kamiyaowl-sandbox/esp_wifi_arduino/docs/表面実装タイプ・クリスタル（水晶発振子）　１６ＭＨｚ（５個入）_ パーツ一般 秋月電子通商 電子部品 ネット通販_files/P-01767.JPG

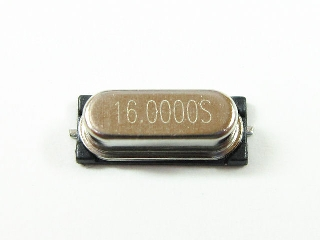
docs/表面実装タイプ・クリスタル（水晶発振子） １６ＭＨｚ（５個入）_ パーツ一般 秋月電子通商 電子部品 ネット通販_files/P-01767.JPG
