kamiyaowl-sandbox/esp_wifi_arduino/部品表.xlsx

Sheet: esp_wifi_arduino
部品名 | パッケージ | 回路リファレンス | 備考 | 実装数 | 10ボード作成で必要数 | 単価 | 販売単位 | 10ボード作成で購入数 | 価格 | 商社 | url
基板 |  |  |  | 1 | 10 | 1389 | 10 | 1 | 1389 | SwitchScience | https://www.switch-science.com/pcborder/
コンデンサ 22pF | SMD1608 | C4 C5 | 水晶接地用12pF~22pF | 2 | 20 | 200 | 100 | 1 | 200 | 秋月電子 | http://akizukidenshi.com/catalog/g/gP-05523/
コンデンサ 10uF | SMD1608 | C9 | レギュレータVout | 1 | 10 | 150 | 10 | 1 | 150 | 秋月電子 | http://akizukidenshi.com/catalog/g/gP-07768/
コンデンサ 0.1uF | SMD1608 | C1 C2 C3 C6 C7 C8 C10 | レギュレータVinも0.1uF | 7 | 70 | 100 | 200 | 1 | 100 | 秋月電子 | http://akizukidenshi.com/catalog/g/gP-04940/
赤色LED | SMD1608 | D1 | 電源LED | 1 | 10 | 200 | 20 | 1 | 200 | 秋月電子 | http://akizukidenshi.com/catalog/g/gI-03978/
青色LED | SMD1608 | D2 | D13 Lチカ用 | 1 | 10 | 200 | 20 | 1 | 200 | 秋月電子 | http://akizukidenshi.com/catalog/g/gI-03982/
抵抗 220Ω | SMD1608 | R1 R2 | LED電流制限用 | 2 | 20 | 500 | 2500 | 1 | 500 | 秋月電子 | http://akizukidenshi.com/catalog/g/gR-06221/
抵抗 10kΩ | SM1608 | R3 R4 R5 R6 R7 | プルアップ抵抗 | 5 | 50 | 500 | 2500 | 1 | 500 | 秋月電子 | http://akizukidenshi.com/catalog/g/gR-06103/
CONN_15 |  | P1 P2 | ピンヘッダ(2.54)×30 | 1 | 10 | 35 | 1 | 10 | 350 | 秋月電子 | http://akizukidenshi.com/catalog/g/gC-00167/
DIPSW4 | SMD4 | SW3 | ESPブートモード設定用 | 1 | 10 | 140 | 1 | 10 | 1400 | 秋月電子 | http://akizukidenshi.com/catalog/g/gP-08929/
SW_PUSH | SMD | SW1 SW2 | リセットスイッチ | 2 | 20 | 100 | 5 | 4 | 400 | 秋月電子 | http://akizukidenshi.com/catalog/g/gP-06185/
ATMEGA328P-A | TQFP32 | IC1 | ATMEGA88シリーズならピンコンパチ | 1 | 10 | 280 | 1 | 10 | 2800 | 秋月電子 | http://akizukidenshi.com/catalog/g/gI-04386/
ESP-WROOM-02 | SMD | U2 | 話題のWifiモジュール | 1 | 10 | 550 | 1 | 10 | 5500 | 秋月電子 | http://akizukidenshi.com/catalog/g/gM-09607/
NJM2391DL1-33 | TO-252-3 | U3 | 3.3V 1Aレギュレータ | 1 | 10 | 200 | 4 | 3 | 600 | 秋月電子 | http://akizukidenshi.com/catalog/g/gI-02252/
16MHz | HC-49 | X1 | 水晶 | 1 | 10 | 200 | 5 | 2 | 400 | 秋月電子 | http://akizukidenshi.com/catalog/g/gP-01767/
ADG3304 | TSSOP14 | U1 | 5V-3.3V双方向レベル変換 | 1 | 10 | 240 | 1 | 10 | 2400 | マルツ | http://www.marutsu.co.jp/pc/i/170346/
 |  |  |  |  |  |  |  | 小計 | 17089

Sheet: 注文履歴
 | 請求額
SwitchScience 基板 | 1713
SwitchScience 基板 | 1713
マルツ ADG3304 10個 | 3030
秋月小計 | 14300
秋月私物注文分 | -5800
 | 14956
