kamiyaowl-sandbox/esp_wifi_arduino/esp_wifi_sch.pdf

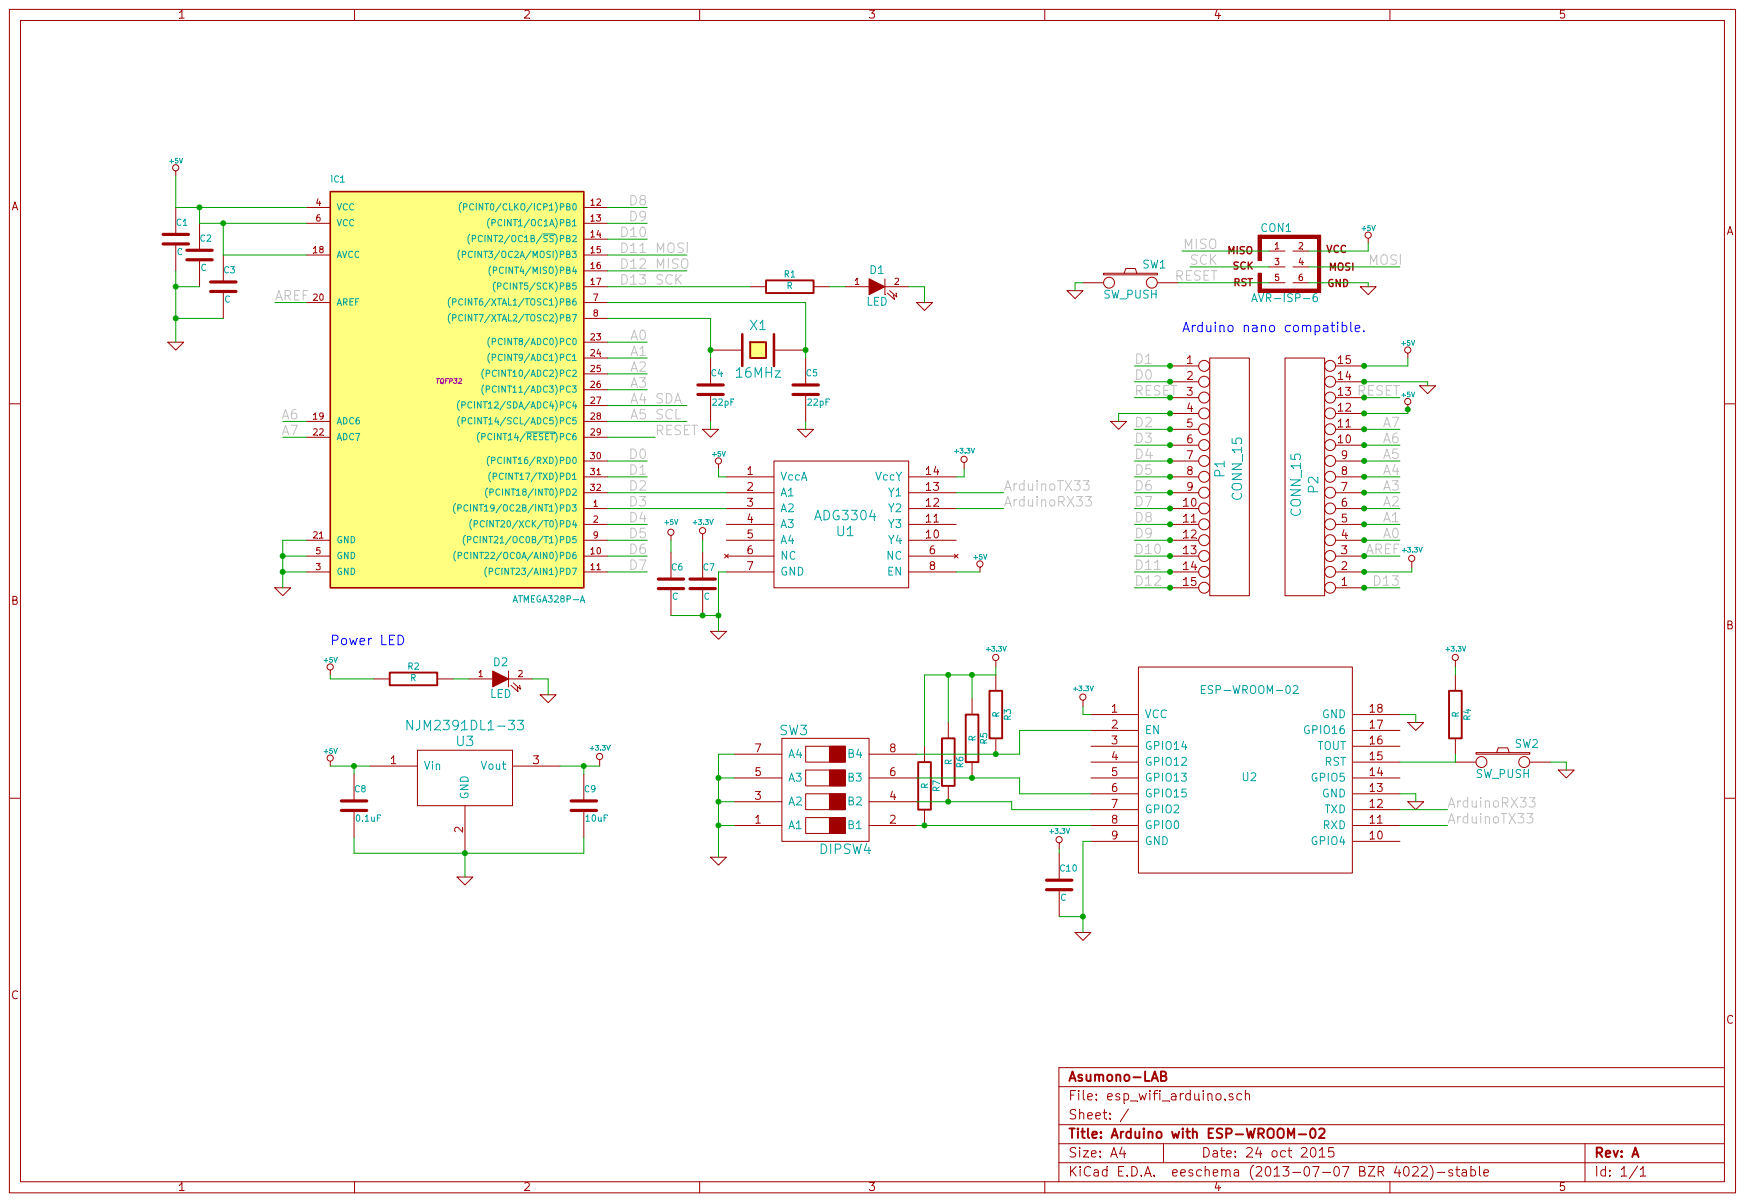
[picture p6: page 1]
