kamiyaowl-sandbox/esp_wifi_arduino/esp_wifi_arduino.kicad_pcb

## KiCad design esp_wifi_arduino.kicad_pcb (2015-12-02)

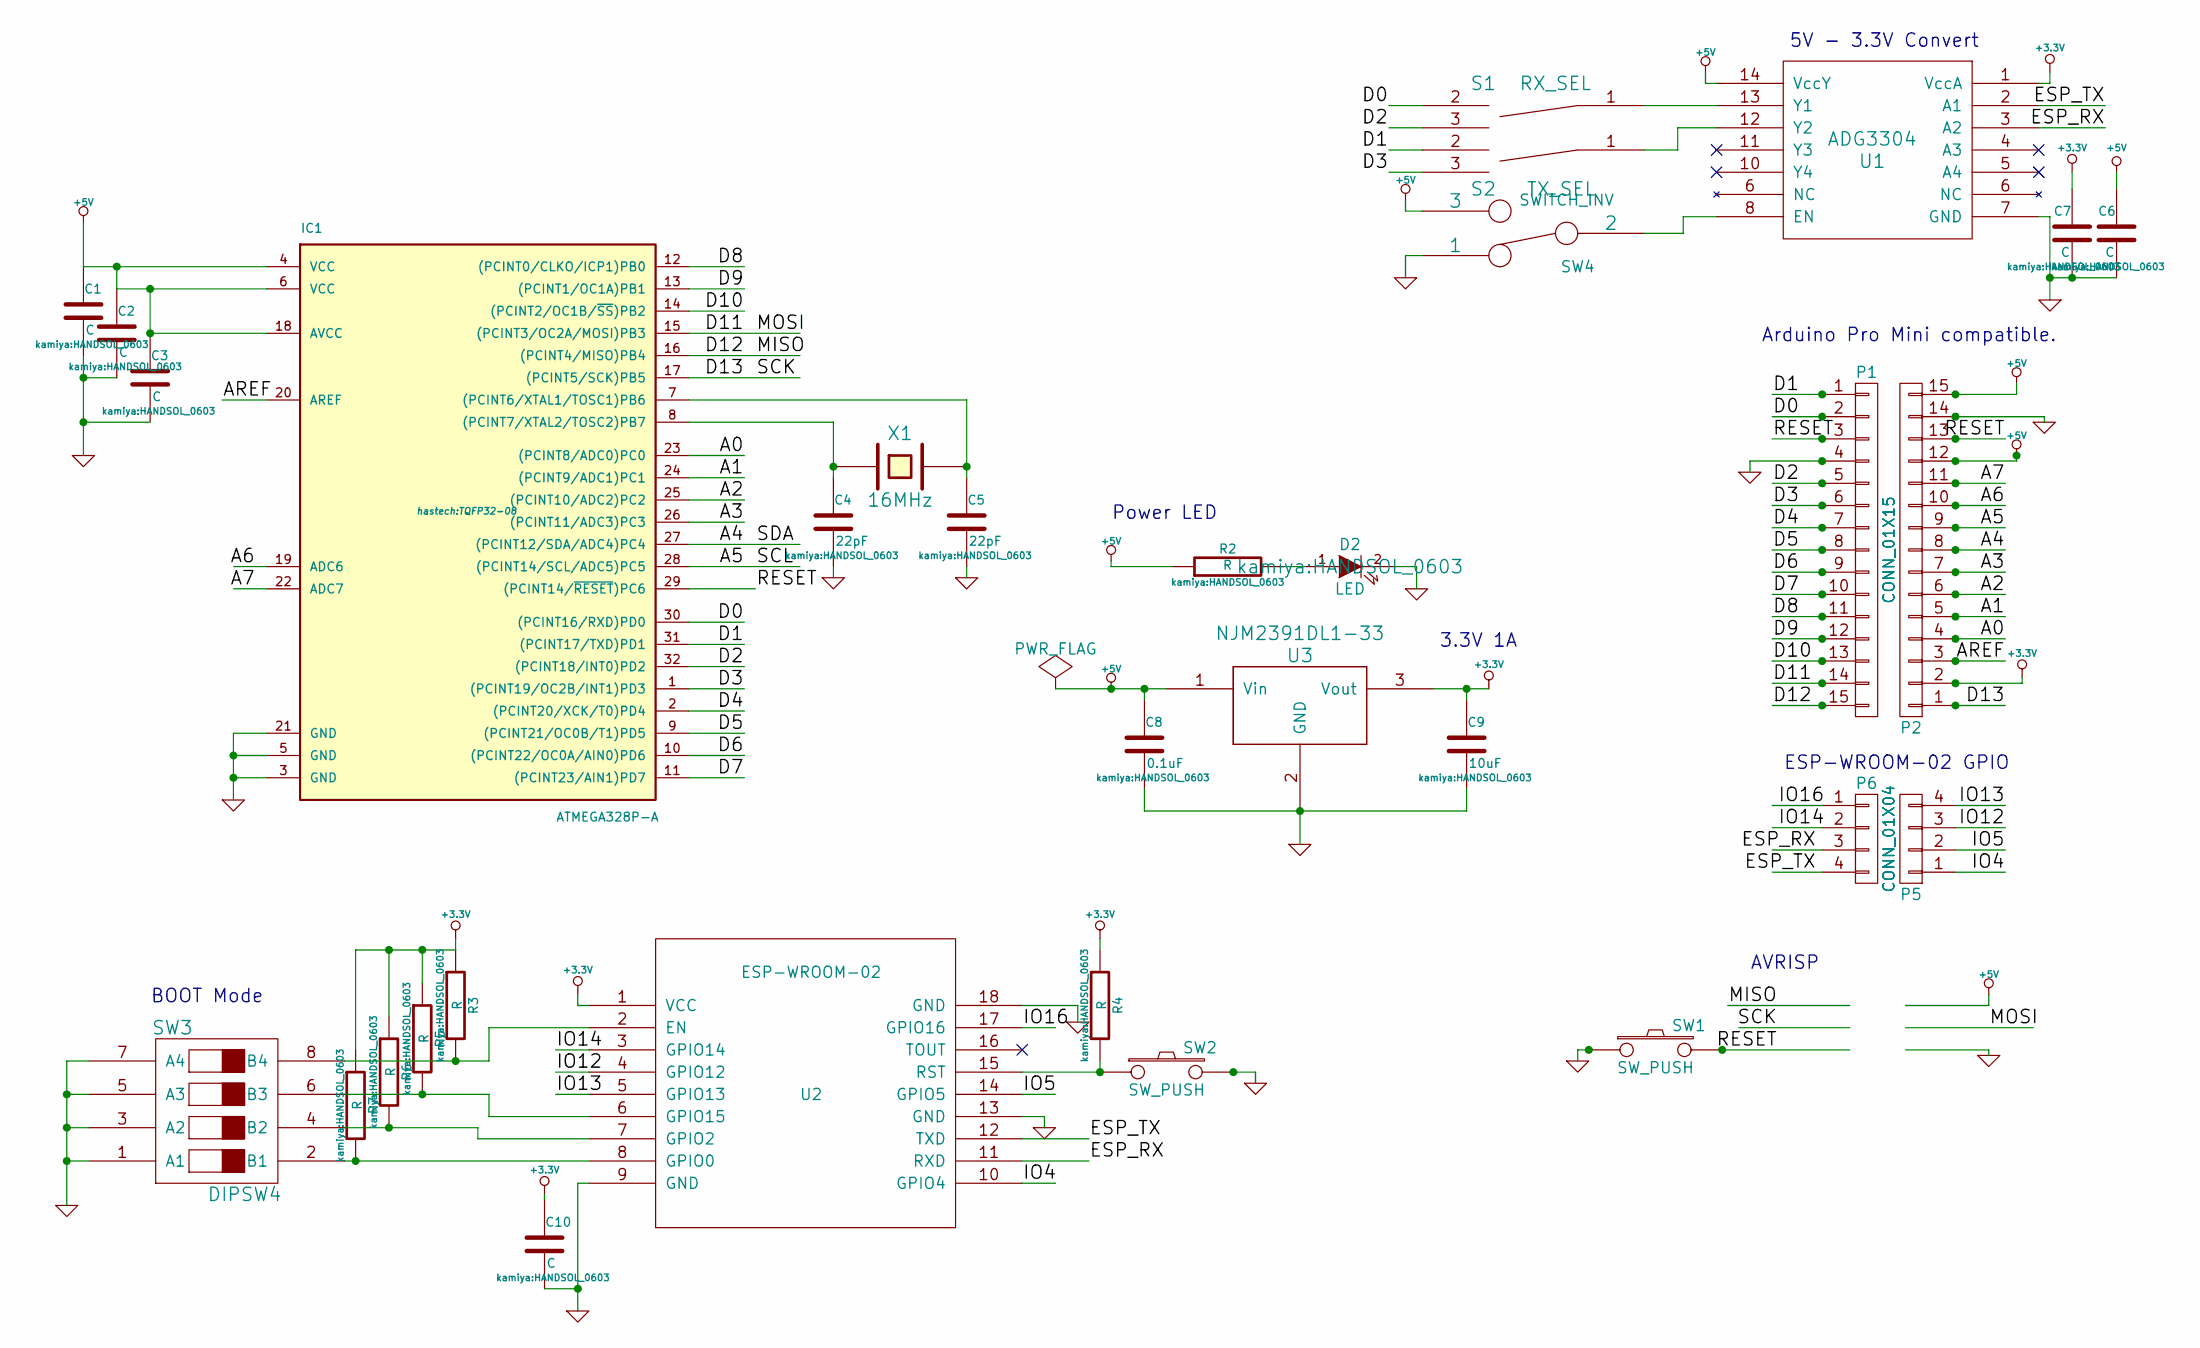
[picture p7: schematic esp_wifi_arduino.sch, Arduino with ESP-WROOM-02]

Parts:
C1, C2, C3, C6, C7, C10: C; HANDSOL_0603
C4, C5: 22pF; HANDSOL_0603
C8: 0.1uF; HANDSOL_0603
C9: 10uF; HANDSOL_0603
D2: LED; HANDSOL_0603
IC1: ATMEGA328P-A; TQFP32-08
P1, P2: CONN_01X15; Pin_Header_Straight_1x15
P5, P6: CONN_01X04; Pin_Header_Straight_1x04
R2, R3, R4, R5, R6, R7: R; HANDSOL_0603
S1: RX_SEL; ALPS_SSSS213202(SlideSW)
S2: TX_SEL; ALPS_SSSS213202(SlideSW)
SW1, SW2: SW_PUSH; ALPS_SW_SKRPACE010
SW3: DIPSW4; OTAX_DIPSW4
SW4: SWITCH_INV
U1: ADG3304; AD_TSSOP-14(0.65)
U2: ESP-WROOM-02; ESP_WROOM_02
U3: NJM2391DL1-33; TO-252-3
X1: 16MHz; XTAL_HC-49

Connections:
+3.3V: C7.1, C9.1, C10.1, P2.2, R3.1, R4.1, R5.1, R6.1, R7.1, U1.1 (VccA), U2.1 (VCC), U3.3 (Vout)
+5V: C1.1, C2.1, C3.1, C6.1, C8.1, IC1.4 (VCC), IC1.6 (VCC), IC1.18 (AVCC), P2.12, P2.15, R2.1, SW4.3, U1.14 (VccY), U3.1 (Vin)
/A0: IC1.23 ((PCINT8/ADC0)PC0), P2.4
/A1: IC1.24 ((PCINT9/ADC1)PC1), P2.5
/A2: IC1.25 ((PCINT10/ADC2)PC2), P2.6
/A3: IC1.26 ((PCINT11/ADC3)PC3), P2.7
/A4: IC1.27 ((PCINT12/SDA/ADC4)PC4), P2.8
/A5: IC1.28 ((PCINT14/SCL/ADC5)PC5), P2.9
/A6: IC1.19 (ADC6), P2.10
/A7: IC1.22 (ADC7), P2.11
/AREF: IC1.20 (AREF), P2.3
/D0: IC1.30 ((PCINT16/RXD)PD0), P1.2, S1.2
/D1: IC1.31 ((PCINT17/TXD)PD1), P1.1, S2.2
/D2: IC1.32 ((PCINT18/INT0)PD2), P1.5, S1.3
/D3: IC1.1 ((PCINT19/OC2B/INT1)PD3), P1.6, S2.3
/D4: IC1.2 ((PCINT20/XCK/T0)PD4), P1.7
/D5: IC1.9 ((PCINT21/OC0B/T1)PD5), P1.8
/D6: IC1.10 ((PCINT22/OC0A/AIN0)PD6), P1.9
/D7: IC1.11 ((PCINT23/AIN1)PD7), P1.10
/D8: IC1.12 ((PCINT0/CLKO/ICP1)PB0), P1.11
/D9: IC1.13 ((PCINT1/OC1A)PB1), P1.12
/D10: IC1.14 ((PCINT2/OC1B/~SS~)PB2), P1.13
/D11: IC1.15 ((PCINT3/OC2A/MOSI)PB3), P1.14
/D12: IC1.16 ((PCINT4/MISO)PB4), P1.15
/D13: IC1.17 ((PCINT5/SCK)PB5), P2.1
/ESP_RX: P6.3, U1.3 (A2), U2.11 (RXD)
/ESP_TX: P6.4, U1.2 (A1), U2.12 (TXD)
/IO4: P5.1, U2.10 (GPIO4)
/IO5: P5.2, U2.14 (GPIO5)
/IO12: P5.3, U2.4 (GPIO12)
/IO13: P5.4, U2.5 (GPIO13)
/IO14: P6.2, U2.3 (GPIO14)
/IO16: P6.1, U2.17 (GPIO16)
/RESET: IC1.29 ((PCINT14/~RESET~)PC6), P1.3, P2.13, SW1.2
GND: C1.2, C2.2, C3.2, C4.2, C5.2, C6.2, C7.2, C8.2, C9.2, C10.2, D2.2 (K), IC1.3 (GND), IC1.5 (GND), IC1.21 (GND), P1.4, P2.14, SW1.1, SW2.2, SW3.1 (A1), SW3.3 (A2), SW3.5 (A3), SW3.7 (A4), SW4.1, U1.7 (GND), U2.9 (GND), U2.13 (GND), U2.18 (GND), U3.2 (GND)
unnamed: D2.1 (A), R2.2
unnamed: SW4.2, U1.8 (EN)
unnamed: R4.2, SW2.1, U2.15 (RST)
unnamed: S1.1, U1.13 (Y1)
unnamed: S2.1, U1.12 (Y2)
unnamed: R7.2, SW3.2 (B1), U2.8 (GPIO0)
unnamed: C4.1, IC1.8 ((PCINT7/XTAL2/TOSC2)PB7), X1.1
unnamed: C5.1, IC1.7 ((PCINT6/XTAL1/TOSC1)PB6), X1.2
unnamed: R3.2, SW3.8 (B4), U2.2 (EN)
unnamed: R5.2, SW3.6 (B3), U2.6 (GPIO15)
unnamed: R6.2, SW3.4 (B2), U2.7 (GPIO2)

Notes on the sheet:
Power LED
Arduino Pro Mini compatible.
5V - 3.3V Convert
3.3V 1A
BOOT Mode
AVRISP
ESP-WROOM-02 GPIO

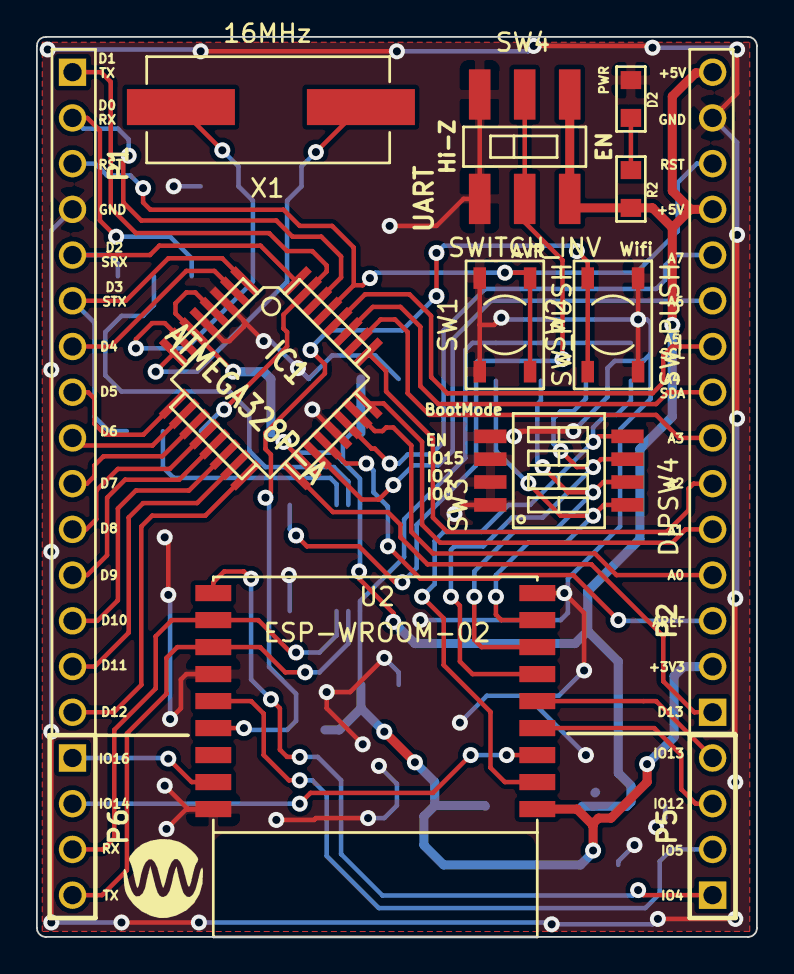
[picture p8: board esp_wifi_arduino.kicad_pcb from above]

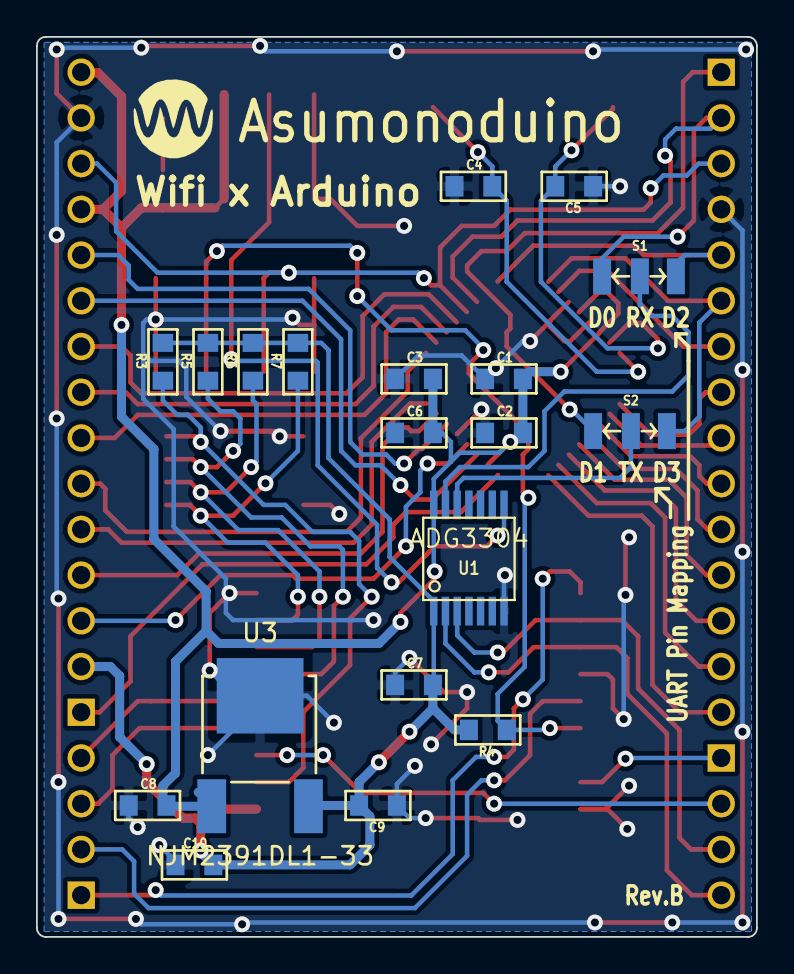
[picture p9: board esp_wifi_arduino.kicad_pcb from below]

Board: 2 copper layers, 40.0 x 50.0 mm, 32 parts (19 on the bottom side), 46 nets.
