kamiyaowl-sandbox/esp_wifi_arduino/(commit log)

2015-10-24 Create Footprint
    [esp_wifi_arduino.kicad_pcb, esp_wifi_arduino.sch]
2015-10-25 Circuit Create
    [esp_wifi_arduino.kicad_pcb, esp_wifi_arduino.sch]
2015-10-25 Fixed: FaceSilk
    [esp_wifi_arduino.kicad_pcb]
2015-10-29 Create: BOM
    [esp_wifi_arduino-2.kicad_pcb, esp_wifi_arduino.csv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]
2015-11-29 Before Rev.B
    [esp_wifi_arduino.sch, 部品表.xlsx]
2015-11-29 PCB Layout
    [esp_wifi_arduino-2.kicad_pcb, esp_wifi_arduino.kicad_pcb, esp_wifi_arduino.sch]
2015-11-29 Draw Pattern
    [esp_wifi_arduino.kicad_pcb, esp_wifi_arduino.sch]
2015-11-30 Create Production File
    [esp_wifi_arduino-revB.gbl, esp_wifi_arduino-revB.gbo, esp_wifi_arduino-revB.gbs, esp_wifi_arduino-revB.gtl, esp_wifi_arduino-revB.gto, esp_wifi_arduino-revB.gts, esp_wifi_arduino.gbl, esp_wifi_arduino.gbo]
2015-12-02 Update Pattern
    [esp_wifi_arduino.kicad_pcb]
